jadudley2/CameraSlide/Electrical/16bit-v0_5.brd

## EAGLE design Electrical/16bit-v0_5.brd (2015-12-26)

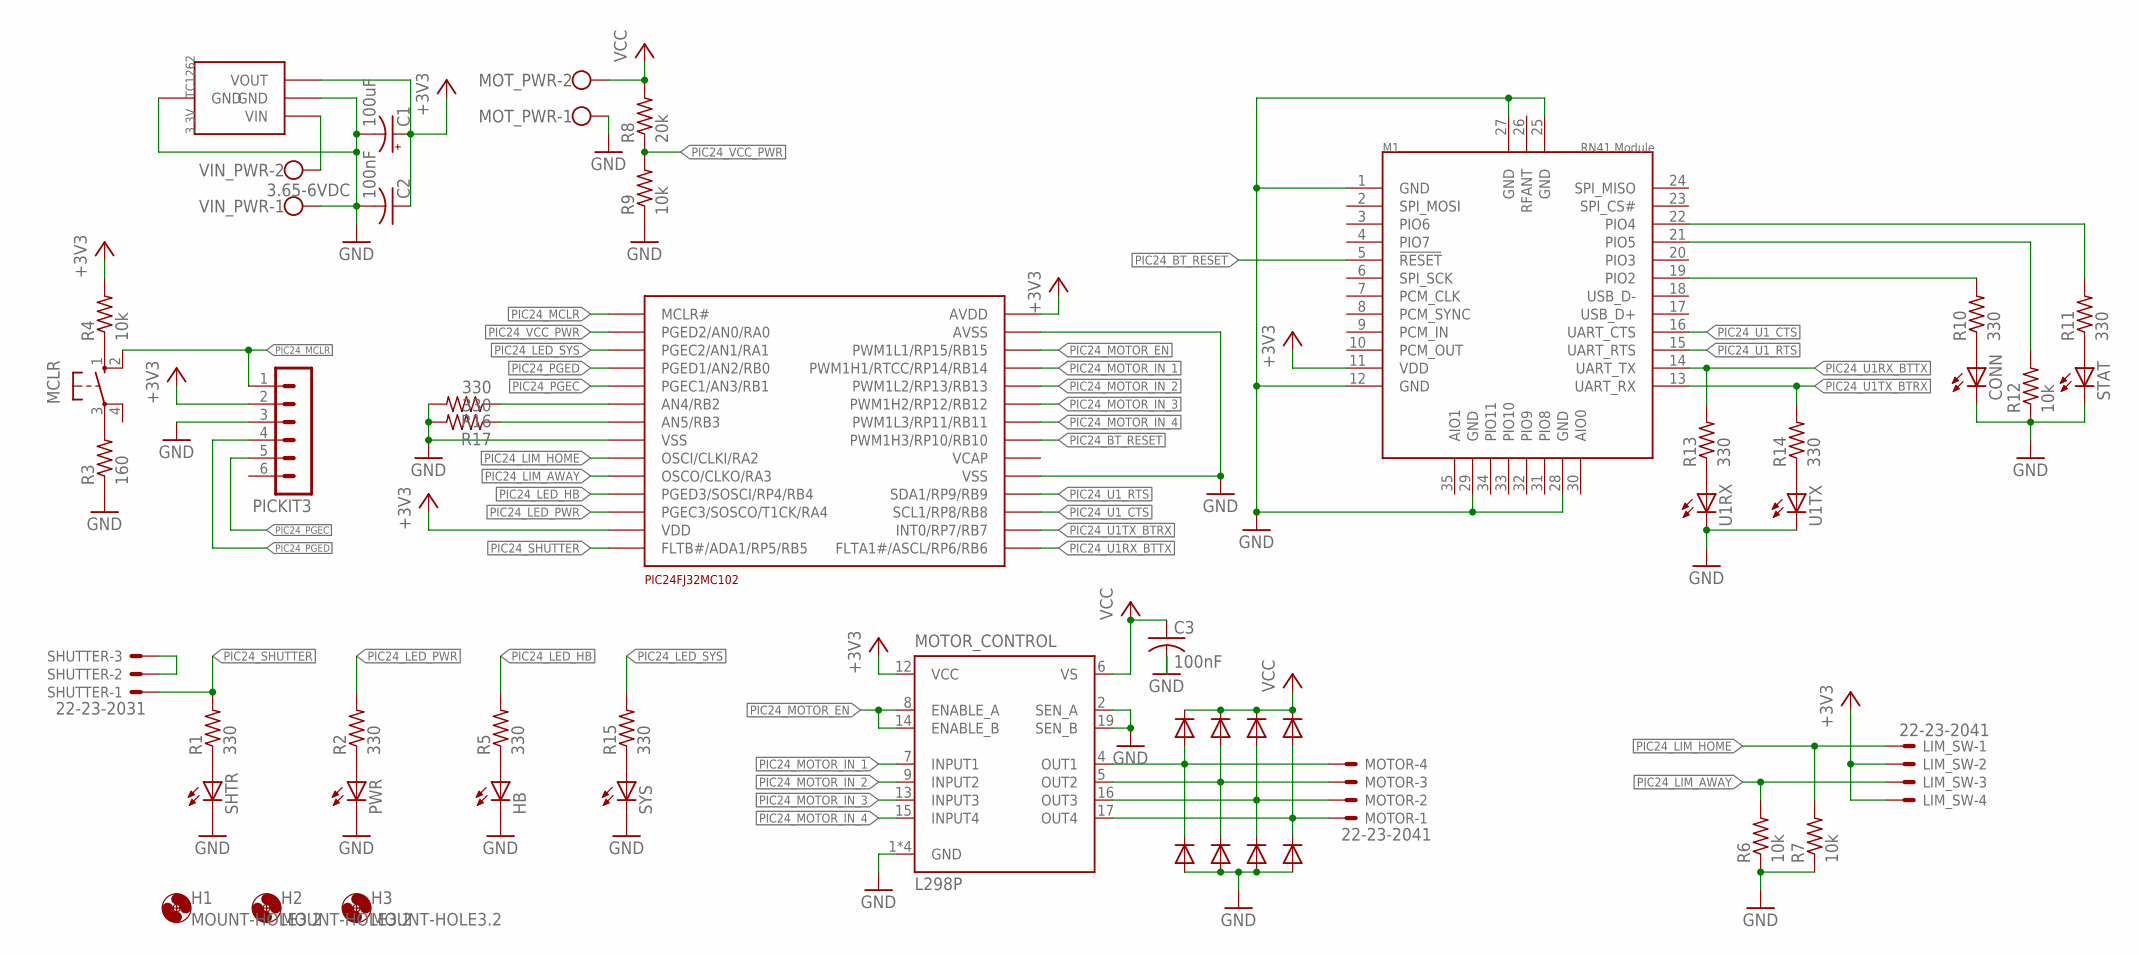
[picture p1: schematic 16bit-v0_5.sch]

Parts:
C1: 100uF; E2,5-7
C2, C3: 100nF; C0402
CONN: LED_ESML0603; LED_SML0603
D1, D2, D3, D4, D5, D6, D7, D8: DIODE-SMB; SMB
H1, H2, H3: MOUNT-HOLE3.2; 3,2
HB: LED_ESML0603; LED_SML0603
LIM_SW: 22-23-2041
MCLR: 10-XX; B3F-10XX
MOTOR: 22-23-2041
MOTOR_CONTROL: L298P; POWERSO-20
MOT_PWR: W237-102
PICKIT3: MA06-1
PWR: LED_ESML0603; LED_SML0603
R1, R2, R5, R10, R11, R13, R14, R15, R16, R17: 330; R0603
R3: 160; R0603
R4, R6, R7, R9, R12: 10k; R0603
R8: 20k; R0603
SHTR: LED_ESML0603; LED_SML0603
SHUTTER: 22-23-2031
STAT: LED_ESML0603; LED_SML0603
SYS: LED_ESML0603; LED_SML0603
U1RX, U1TX: LED_ESML0603; LED_SML0603
U$1: PIC24FJ32MC102; PIC2428-SOIC
U$2: RN41N
U$3: TC1262-3.3VDBTR; TO-261-4
VIN_PWR: 3.65-6VDC; W237-102

Connections:
+3V3: C1.+, C2.1, LIM_SW.2, LIM_SW.4, MOTOR_CONTROL.12 (VCC), PICKIT3.2, R4.2, U$1.AVDD, U$1.VDD, U$2.11 (VDD), U$3.P$3 (VOUT)
GND: C1.-, C2.2, C3.2, CONN.C, D5.A, D6.A, D7.A, D8.A, HB.C, MOTOR_CONTROL.1 (GND), MOTOR_CONTROL.2 (SEN_A), MOTOR_CONTROL.10 (GND), MOTOR_CONTROL.11 (GND), MOTOR_CONTROL.19 (SEN_B), MOTOR_CONTROL.20 (GND), MOT_PWR.1, PICKIT3.3, PWR.C, R3.1, R6.1, R7.1, R9.1, R12.1, R16.2, R17.2, SHTR.C, STAT.C, SYS.C, U1RX.C, U1TX.C, U$1.AVSS, U$1.VSS@8 (VSS), U$1.VSS@19 (VSS), U$2.1 (GND), U$2.12 (GND), U$2.25 (GND), U$2.27 (GND), U$2.28 (GND), U$2.29 (GND), U$3.P$2 (GND), U$3.P$4 (GND), VIN_PWR.1
MOTOR_OUT_1: D1.A, D5.C, MOTOR.4, MOTOR_CONTROL.4 (OUT1)
MOTOR_OUT_2: D2.A, D6.C, MOTOR.3, MOTOR_CONTROL.5 (OUT2)
MOTOR_OUT_3: D3.A, D7.C, MOTOR.2, MOTOR_CONTROL.16 (OUT3)
MOTOR_OUT_4: D4.A, D8.C, MOTOR.1, MOTOR_CONTROL.17 (OUT4)
unnamed: R13.1, U1RX.A
unnamed: MCLR.3, R3.2
unnamed: MCLR.1 (S), R4.1
unnamed: R1.1, SHTR.A
unnamed: R12.2, U$2.21 (PIO5)
unnamed: PWR.A, R2.1
unnamed: HB.A, R5.1
unnamed: R15.1, SYS.A
unnamed: R14.1, U1TX.A
unnamed: R11.2, U$2.22 (PIO4)
unnamed: R10.2, U$2.19 (PIO2)
unnamed: CONN.A, R10.1
unnamed: R11.1, STAT.A
PIC24_BT_!RESET: U$1.RB10 (PWM1H3/RP10/RB10), U$2.5 (!RESET)
PIC24_EXTRA_1: R16.1, U$1.RB2 (AN4/RB2)
PIC24_EXTRA_2: R17.1, U$1.RB3 (AN5/RB3)
PIC24_LED_HB: R5.2, U$1.RB4 (PGED3/SOSCI/RP4/RB4)
PIC24_LED_PWR: R2.2, U$1.RA4 (PGEC3/SOSCO/T1CK/RA4)
PIC24_LED_SYS: R15.2, U$1.RA1 (PGEC2/AN1/RA1)
PIC24_LIM_AWAY: LIM_SW.3, R6.2, U$1.RA3 (OSCO/CLKO/RA3)
PIC24_LIM_HOME: LIM_SW.1, R7.2, U$1.RA2 (OSCI/CLKI/RA2)
PIC24_MCLR: MCLR.2 (S1), PICKIT3.1, U$1.MCLR#
PIC24_MOTOR_EN: MOTOR_CONTROL.8 (ENABLE_A), MOTOR_CONTROL.14 (ENABLE_B), U$1.RB15 (PWM1L1/RP15/RB15)
PIC24_MOTOR_IN_1: MOTOR_CONTROL.7 (INPUT1), U$1.RB14 (PWM1H1/RTCC/RP14/RB14)
PIC24_MOTOR_IN_2: MOTOR_CONTROL.9 (INPUT2), U$1.RB13 (PWM1L2/RP13/RB13)
PIC24_MOTOR_IN_3: MOTOR_CONTROL.13 (INPUT3), U$1.RB12 (PWM1H2/RP12/RB12)
PIC24_MOTOR_IN_4: MOTOR_CONTROL.15 (INPUT4), U$1.RB11 (PWM1L3/RP11/RB11)
PIC24_PGEC: PICKIT3.5, U$1.PGEC1 (PGEC1/AN3/RB1)
PIC24_PGED: PICKIT3.4, U$1.PGED1 (PGED1/AN2/RB0)
PIC24_SHUTTER: R1.2, SHUTTER.1, U$1.RB5 (FLTB#/ADA1/RP5/RB5)
PIC24_U1RX_BTTX: R13.2, U$1.RB6 (FLTA1#/ASCL/RP6/RB6), U$2.14 (UART_TX)
PIC24_U1TX_BTRX: R14.2, U$1.RB7 (INT0/RP7/RB7), U$2.13 (UART_RX)
PIC24_U1_CTS: U$1.RB8 (SCL1/RP8/RB8), U$2.16 (UART_CTS)
PIC24_U1_RTS: U$1.RB9 (SDA1/RP9/RB9), U$2.15 (UART_RTS)
PIC24_VCC_PWR: R8.1, R9.2, U$1.RA0 (PGED2/AN0/RA0)
SHUTTER_SHORT: SHUTTER.2, SHUTTER.3
VCC: C3.1, D1.C, D2.C, D3.C, D4.C, MOTOR_CONTROL.6 (VS), MOT_PWR.2, R8.2
VIN_PWR: U$3.P$1 (VIN), VIN_PWR.2

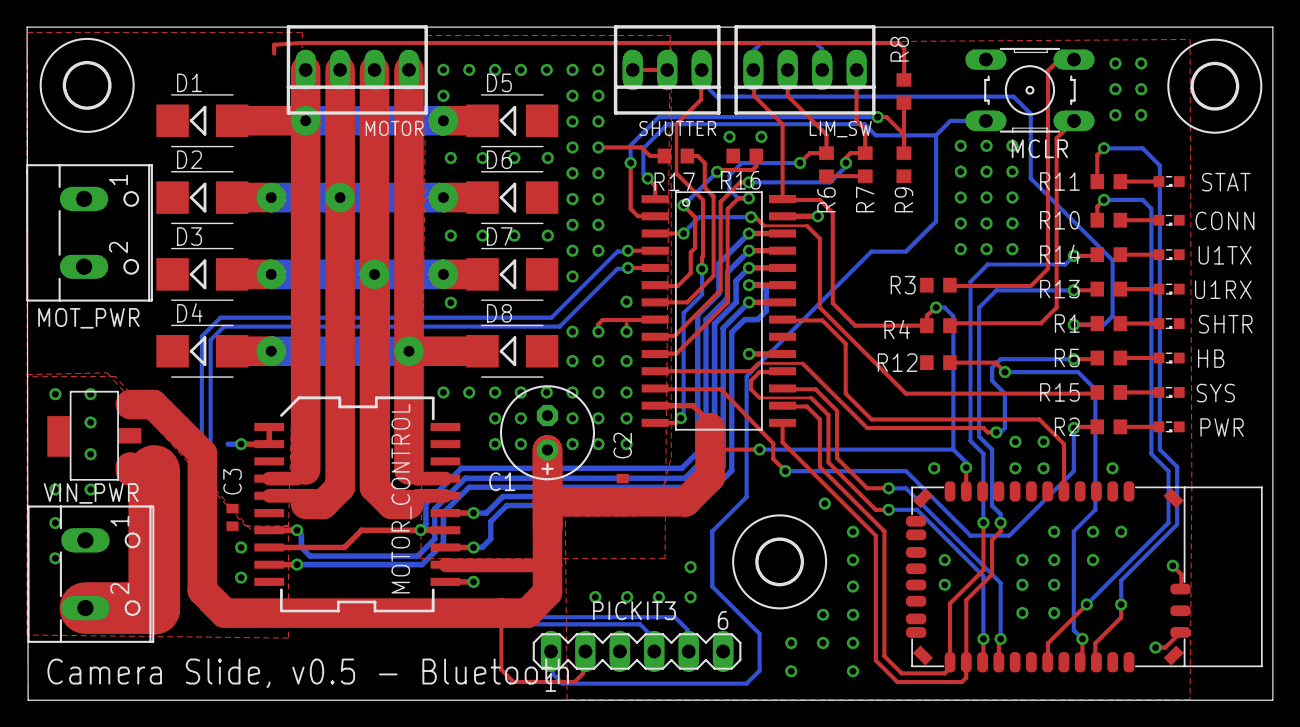
[picture p2: board 16bit-v0_5.brd from above]

Board: 2 copper layers, 91.9 x 49.7 mm, 50 parts (0 on the bottom side), 44 nets.
