jadudley2/CameraSlide/Electrical/16bit-v0_2.brd

## EAGLE design Electrical/16bit-v0_2.brd (2015-06-11, an earlier design)

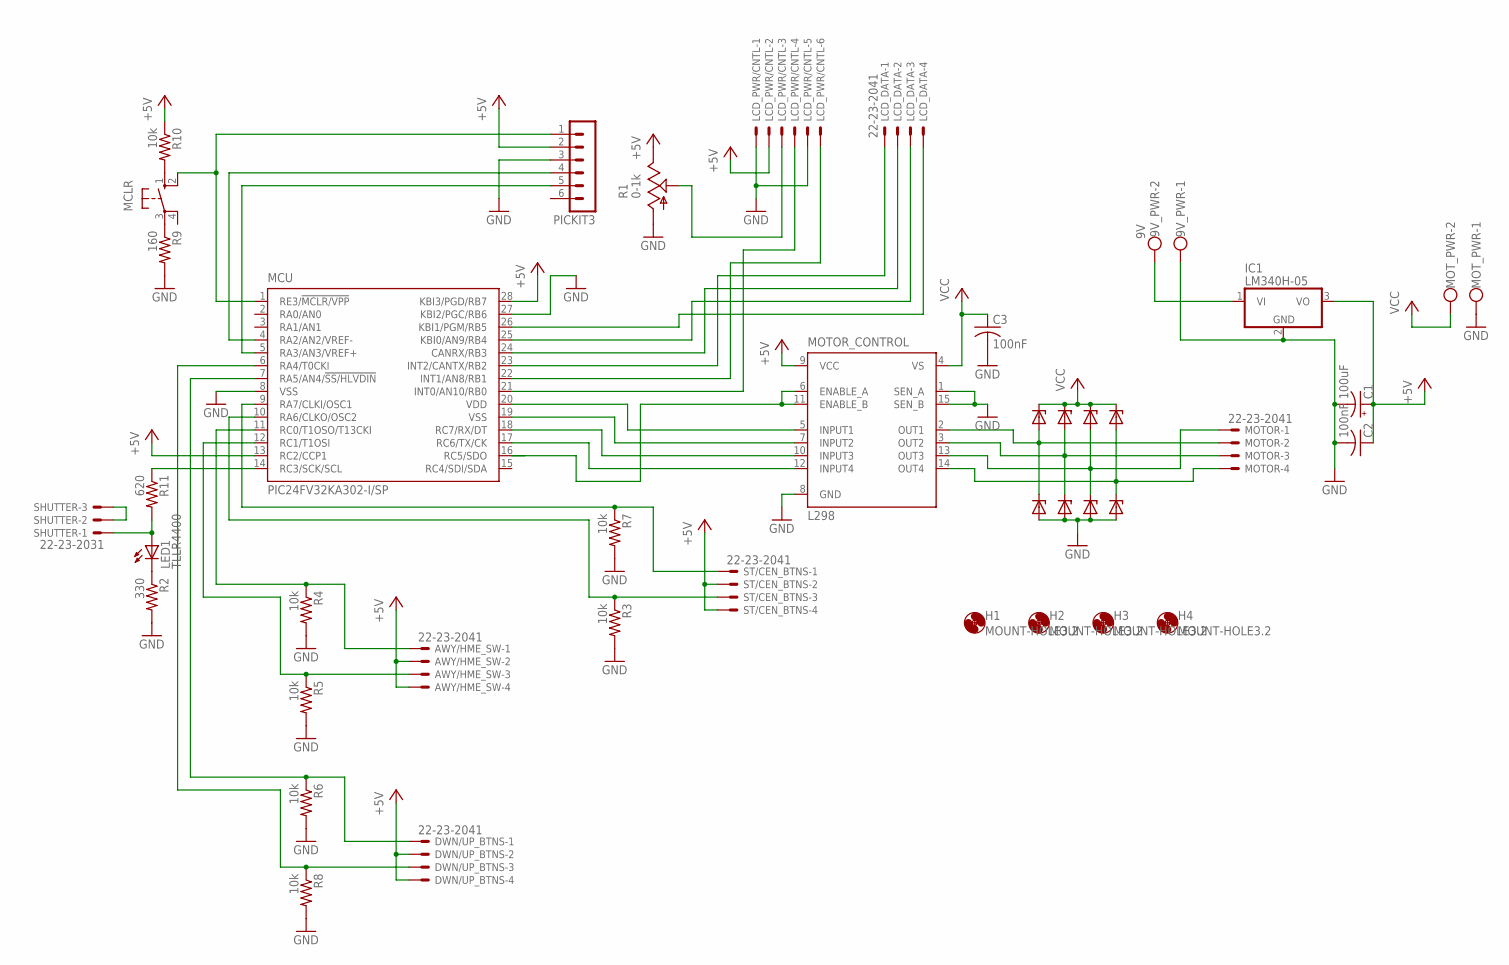
[picture p3: schematic 16bit-v0_2.sch]

Parts:
9V_PWR: 9V; W237-102
AWY/HME_SW: 22-23-2041
C1: 100uF; E2,5-7
C2, C3: 100nF; C025-025X050
D1, D2, D3, D4, D5, D6, D7, D8: BZX90; DO34Z7
DWN/UP_BTNS: 22-23-2041
H1, H2, H3, H4: MOUNT-HOLE3.2; 3,2
IC1: LM340H-05; TO220H
LCD_DATA: 22-23-2041
LCD_PWR/CNTL: 22-23-2061
LED1: TLLR4400; LED3MM
MCLR: 10-XX; B3F-10XX
MCU: PIC18F2580-I/SP; DIL28-3; MPN PIC24FV32KA302-I/SP
MOTOR: 22-23-2041
MOTOR_CONTROL: L298; MULTIWATT-15
MOT_PWR: W237-102
PICKIT3: MA06-1
R1: 0-1k; B25P
R2: 330; 0207/7
R3, R4, R5, R6, R7, R8, R10: 10k; 0207/7
R9: 160; 0207/7
R11: 620; 0207/7
SHUTTER: 22-23-2031
ST/CEN_BTNS: 22-23-2041

Connections:
+5V: AWY/HME_SW.2, AWY/HME_SW.4, C1.+, C2.1, DWN/UP_BTNS.2, DWN/UP_BTNS.4, IC1.3 (VO), LCD_PWR/CNTL.2, MCU.13 (RC2/CCP1), MCU.28 (KBI3/PGD/RB7), MOTOR_CONTROL.9 (VCC), PICKIT3.2, R1.E, R10.1, ST/CEN_BTNS.2, ST/CEN_BTNS.4
GND: 9V_PWR.1, C1.-, C2.2, C3.2, D5.A, D6.A, D7.A, D8.A, IC1.2 (GND), LCD_PWR/CNTL.1, LCD_PWR/CNTL.5, MCU.8 (VSS), MCU.27 (KBI2/PGC/RB6), MOTOR_CONTROL.8 (GND), MOT_PWR.1, PICKIT3.3, R1.A, R2.2, R3.2, R4.2, R5.2, R6.2, R7.2, R8.2, R9.2
unnamed: MCLR.2 (S1), MCU.1 (RE3/!MCLR/VPP), PICKIT3.1
unnamed: MCU.5 (RA3/AN3/VREF+), PICKIT3.5
unnamed: MCU.4 (RA2/AN2/VREF-), PICKIT3.4
unnamed: LED1.K (C), R2.1
unnamed: MOTOR_CONTROL.1 (SEN_A), MOTOR_CONTROL.15 (SEN_B)
unnamed: MCU.14 (RC3/SCK/SCL), R11.1
unnamed: MCU.16 (RC5/SDO), MOTOR_CONTROL.6 (ENABLE_A), MOTOR_CONTROL.11 (ENABLE_B)
unnamed: LCD_PWR/CNTL.3, R1.S
unnamed: LCD_PWR/CNTL.4, MCU.21 (INT0/AN10/RB0)
unnamed: LCD_PWR/CNTL.6, MCU.22 (INT1/AN8/RB1)
unnamed: LCD_DATA.2, MCU.24 (CANRX/RB3)
unnamed: LCD_DATA.3, MCU.25 (KBI0/AN9/RB4)
unnamed: LCD_DATA.4, MCU.26 (KBI1/PGM/RB5)
unnamed: MCU.17 (RC6/TX/CK), MOTOR_CONTROL.12 (INPUT4)
unnamed: AWY/HME_SW.1, MCU.11 (RC0/T1OSO/T13CKI), R4.1
unnamed: D2.A, D6.C, MOTOR.3, MOTOR_CONTROL.3 (OUT2)
unnamed: D3.A, D7.C, MOTOR.1, MOTOR_CONTROL.13 (OUT3)
unnamed: D4.A, D8.C, MOTOR.4, MOTOR_CONTROL.14 (OUT4)
unnamed: LED1.A, R11.2, SHUTTER.1
unnamed: LCD_DATA.1, MCU.23 (INT2/CANTX/RB2)
unnamed: MCU.10 (RA6/CLKO/OSC2), R3.1, ST/CEN_BTNS.3
unnamed: MCU.18 (RC7/RX/DT), MOTOR_CONTROL.10 (INPUT3)
unnamed: DWN/UP_BTNS.1, MCU.7 (RA5/AN4/!SS/HLVDIN), R6.1
unnamed: MCU.9 (RA7/CLKI/OSC1), R7.1, ST/CEN_BTNS.1
unnamed: DWN/UP_BTNS.3, MCU.6 (RA4/T0CKI), R8.1
unnamed: MCU.19 (VSS), MOTOR_CONTROL.7 (INPUT2)
unnamed: AWY/HME_SW.3, MCU.12 (RC1/T1OSI), R5.1
unnamed: D1.A, D5.C, MOTOR.2, MOTOR_CONTROL.2 (OUT1)
unnamed: MCU.20 (VDD), MOTOR_CONTROL.5 (INPUT1)
unnamed: MCLR.1 (S), R10.2
unnamed: SHUTTER.2, SHUTTER.3
unnamed: MCLR.3, R9.1
unnamed: 9V_PWR.2, IC1.1 (VI)
VCC: C3.1, D1.C, D2.C, D3.C, D4.C, MOTOR_CONTROL.4 (VS), MOT_PWR.2

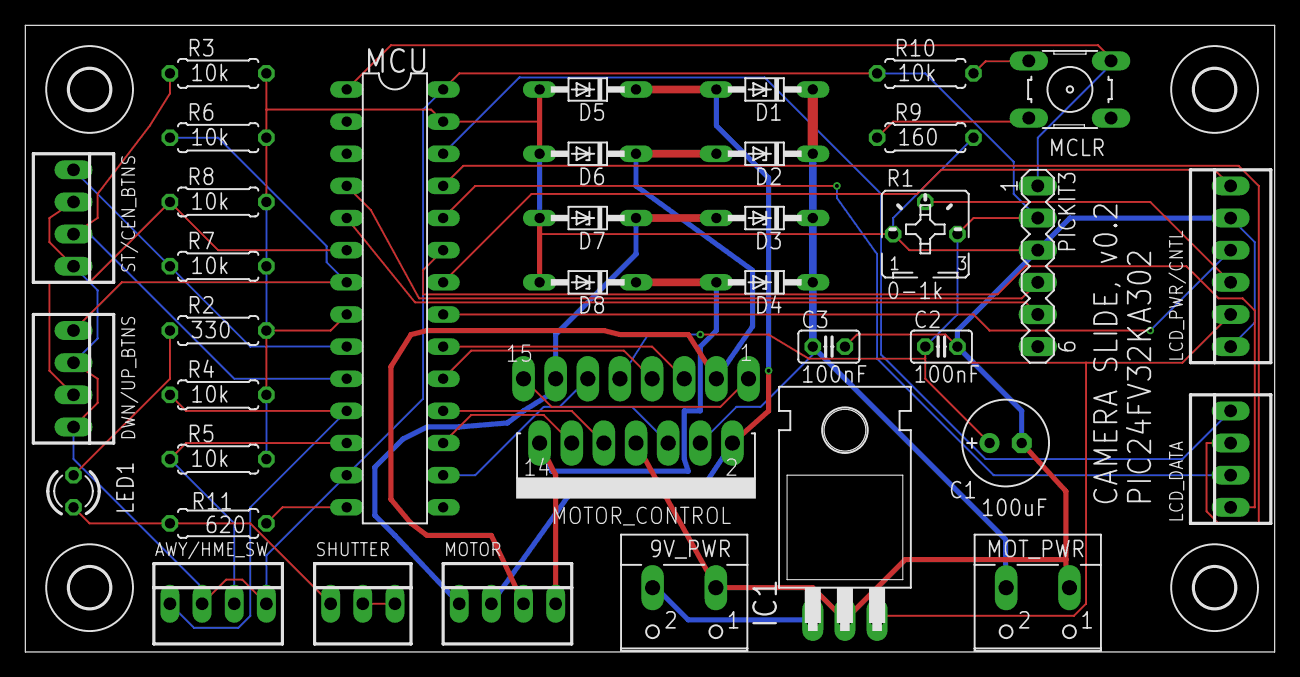
[picture p4: board 16bit-v0_2.brd from above]

Board: 2 copper layers, 98.7 x 49.5 mm, 41 parts (0 on the bottom side), 36 nets.
