jadudley2/CameraSlide/Electrical/8bit-v0_3.brd

## EAGLE design Electrical/8bit-v0_3.brd (2015-06-11)

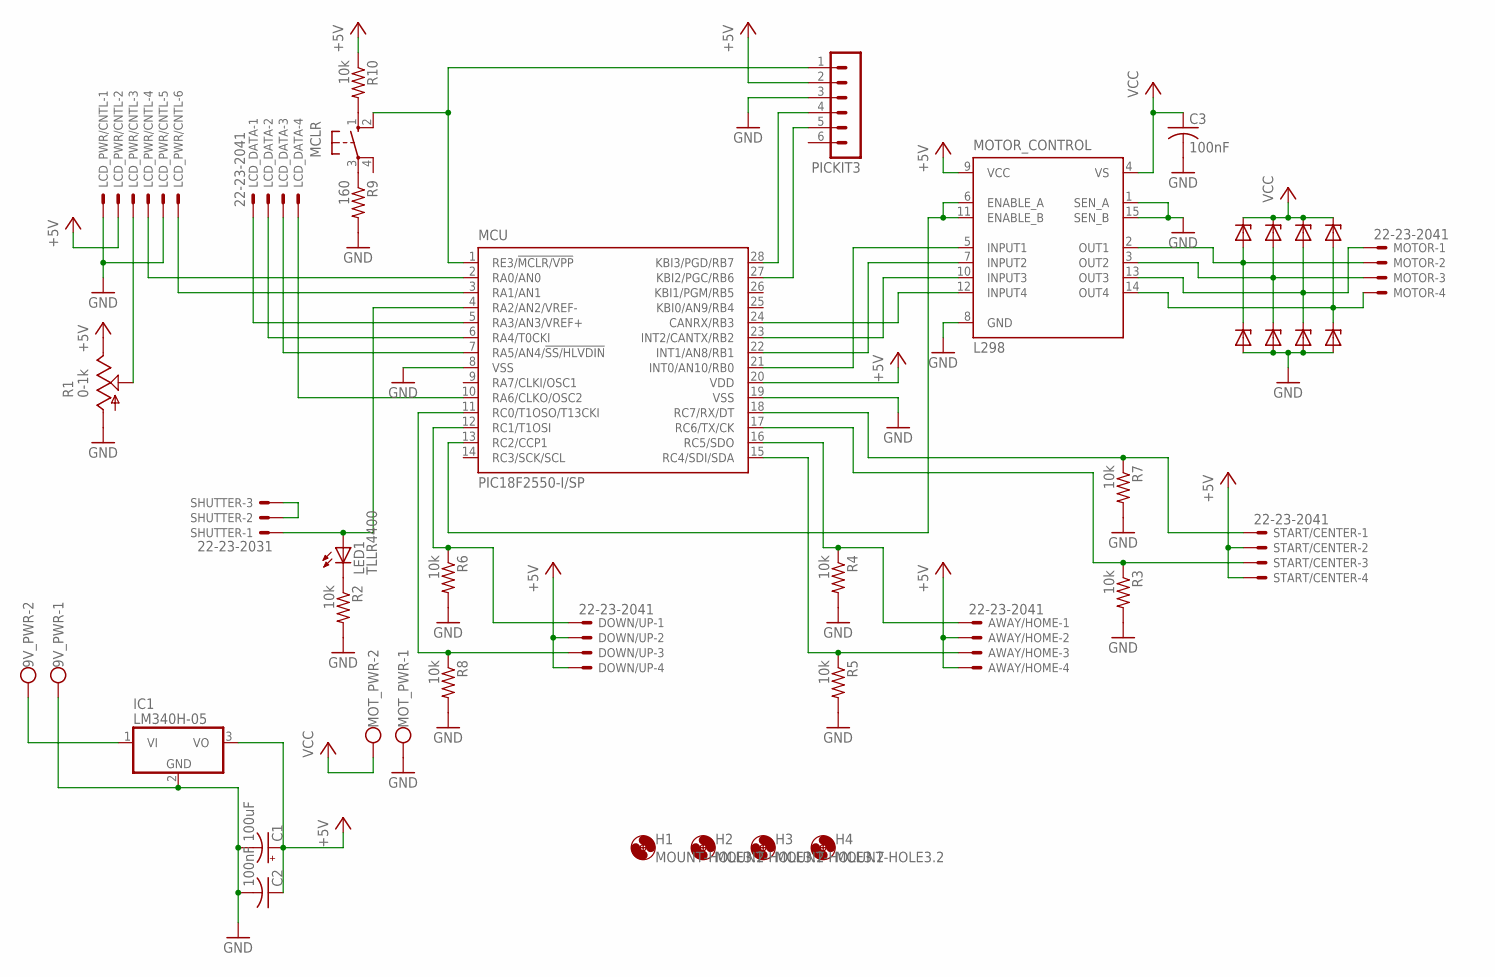
[picture p5: schematic 8bit-v0_3.sch]

Parts:
9V_PWR: W237-102
AWAY/HOME: 22-23-2041
C1: 100uF; E2,5-7
C2, C3: 100nF; C025-025X050
D1, D2, D3, D4, D5, D6, D7, D8: BZX90; DO34Z7
DOWN/UP: 22-23-2041
H1, H2, H3, H4: MOUNT-HOLE3.2; 3,2
IC1: LM340H-05; TO220H
LCD_DATA: 22-23-2041
LCD_PWR/CNTL: 22-23-2061
LED1: TLLR4400; LED3MM
MCLR: 10-XX; B3F-10XX
MCU: PIC18F2580-I/SP; DIL28-3; MPN PIC18F2550-I/SP
MOTOR: 22-23-2041
MOTOR_CONTROL: L298; MULTIWATT-15
MOT_PWR: W237-102
PICKIT3: MA06-1
R1: 0-1k; B25P
R2, R3, R4, R5, R6, R7, R8, R10: 10k; 0207/10
R9: 160; 0207/10
SHUTTER: 22-23-2031
START/CENTER: 22-23-2041

Connections:
+5V: AWAY/HOME.2, AWAY/HOME.4, C1.+, C2.1, DOWN/UP.2, DOWN/UP.4, IC1.3 (VO), LCD_PWR/CNTL.2, MCU.20 (VDD), MOTOR_CONTROL.9 (VCC), PICKIT3.2, R1.E, R10.1, START/CENTER.2, START/CENTER.4
GND: 9V_PWR.1, C1.-, C2.2, C3.2, D5.A, D6.A, D7.A, D8.A, IC1.2 (GND), LCD_PWR/CNTL.1, LCD_PWR/CNTL.5, MCU.8 (VSS), MCU.19 (VSS), MOTOR_CONTROL.8 (GND), MOT_PWR.1, PICKIT3.3, R1.A, R2.2, R3.2, R4.2, R5.2, R6.2, R7.2, R8.2, R9.2
unnamed: MCLR.2 (S1), MCU.1 (RE3/!MCLR/VPP), PICKIT3.1
unnamed: MCU.27 (KBI2/PGC/RB6), PICKIT3.5
unnamed: MCU.28 (KBI3/PGD/RB7), PICKIT3.4
unnamed: LCD_PWR/CNTL.3, R1.S
unnamed: MOTOR_CONTROL.1 (SEN_A), MOTOR_CONTROL.15 (SEN_B)
unnamed: MCU.24 (CANRX/RB3), MOTOR_CONTROL.12 (INPUT4)
unnamed: MCU.23 (INT2/CANTX/RB2), MOTOR_CONTROL.10 (INPUT3)
unnamed: MCU.22 (INT1/AN8/RB1), MOTOR_CONTROL.7 (INPUT2)
unnamed: LCD_PWR/CNTL.4, MCU.2 (RA0/AN0)
unnamed: LCD_PWR/CNTL.6, MCU.3 (RA1/AN1)
unnamed: LCD_DATA.1, MCU.5 (RA3/AN3/VREF+)
unnamed: LCD_DATA.3, MCU.7 (RA5/AN4/!SS/HLVDIN)
unnamed: LCD_DATA.4, MCU.10 (RA6/CLKO/OSC2)
unnamed: MCU.21 (INT0/AN10/RB0), MOTOR_CONTROL.5 (INPUT1)
unnamed: AWAY/HOME.1, MCU.16 (RC5/SDO), R4.1
unnamed: D2.A, D6.C, MOTOR.3, MOTOR_CONTROL.3 (OUT2)
unnamed: D3.A, D7.C, MOTOR.1, MOTOR_CONTROL.13 (OUT3)
unnamed: D4.A, D8.C, MOTOR.4, MOTOR_CONTROL.14 (OUT4)
unnamed: AWAY/HOME.3, MCU.15 (RC4/SDI/SDA), R5.1
unnamed: LCD_DATA.2, MCU.6 (RA4/T0CKI)
unnamed: MCU.17 (RC6/TX/CK), R3.1, START/CENTER.3
unnamed: LED1.K (C), R2.1
unnamed: DOWN/UP.1, MCU.12 (RC1/T1OSI), R6.1
unnamed: MCU.18 (RC7/RX/DT), R7.1, START/CENTER.1
unnamed: DOWN/UP.3, MCU.11 (RC0/T1OSO/T13CKI), R8.1
unnamed: D1.A, D5.C, MOTOR.2, MOTOR_CONTROL.2 (OUT1)
unnamed: MCU.13 (RC2/CCP1), MOTOR_CONTROL.6 (ENABLE_A), MOTOR_CONTROL.11 (ENABLE_B)
unnamed: LED1.A, MCU.4 (RA2/AN2/VREF-), SHUTTER.1
unnamed: MCLR.1 (S), R10.2
unnamed: SHUTTER.2, SHUTTER.3
unnamed: MCLR.3, R9.1
unnamed: 9V_PWR.2, IC1.1 (VI)
VCC: C3.1, D1.C, D2.C, D3.C, D4.C, MOTOR_CONTROL.4 (VS), MOT_PWR.2

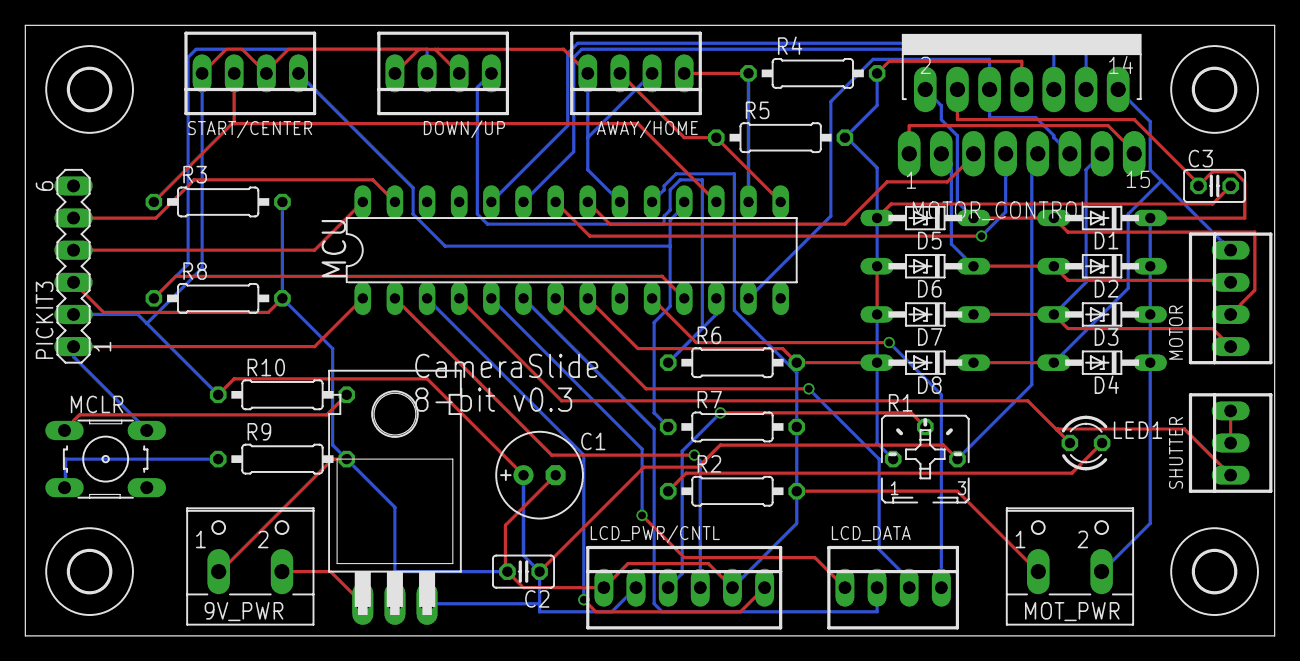
[picture p6: board 8bit-v0_3.brd from above]

Board: 2 copper layers, 98.7 x 48.2 mm, 40 parts (0 on the bottom side), 35 nets.
