jadudley2/CameraSlide/Software/CameraSlideBlue-16bit/motor.h

/* 
 * File:   motor.h
 * Author: jadudley
 *
 * Created on April 2, 2015, 8:55 PM
 */

#ifndef MOTOR_H
#define	MOTOR_H

#include "constants.h"
#include "TMR32.h"

/*
 * moveSingleStep
 * advances stepper motor a single step in prescribed direction
 * takes: unsigned char representing direction to turn stepper
 * returns: nothing
 */
unsigned char moveSingleStep(unsigned char dir);

void motor_setSpeed(unsigned int spd);

void motor_init(unsigned int spd, unsigned int stepsPerRev);

#endif	/* MOTOR_H */
