jadudley2/CameraSlide/Software/CameraSlideBlue-16bit/ADC.h

/* 
 * File:   ADC.h
 * Author: James Dudley
 *
 * Created on November 21, 2015, 6:31 PM
 */

#ifndef ADC_H
#define	ADC_H

#include "constants.h"

void ADC_init(void);

unsigned int ADC_rawValue(void);

#endif	/* ADC_H */
