jadudley2/CameraSlide/(commit log)

2015-12-26 Cleaned up old versions, working on v0.5 bluetooth
    [16bit-v0_5.brd, 16bit-v0_5.sch]
2015-12-26 Switched over to interrupt-based UART tx/rx handling
2016-01-09 Added PWR LED with ADC functionality
